vroland/epdiy-hardware/adapters/40_to_WP27D-P050VA3/40_to_WP27D-P050VA3.kicad_pcb

## KiCad design adapters/40_to_WP27D-P050VA3/40_to_WP27D-P050VA3.kicad_pcb (2025-03-17)

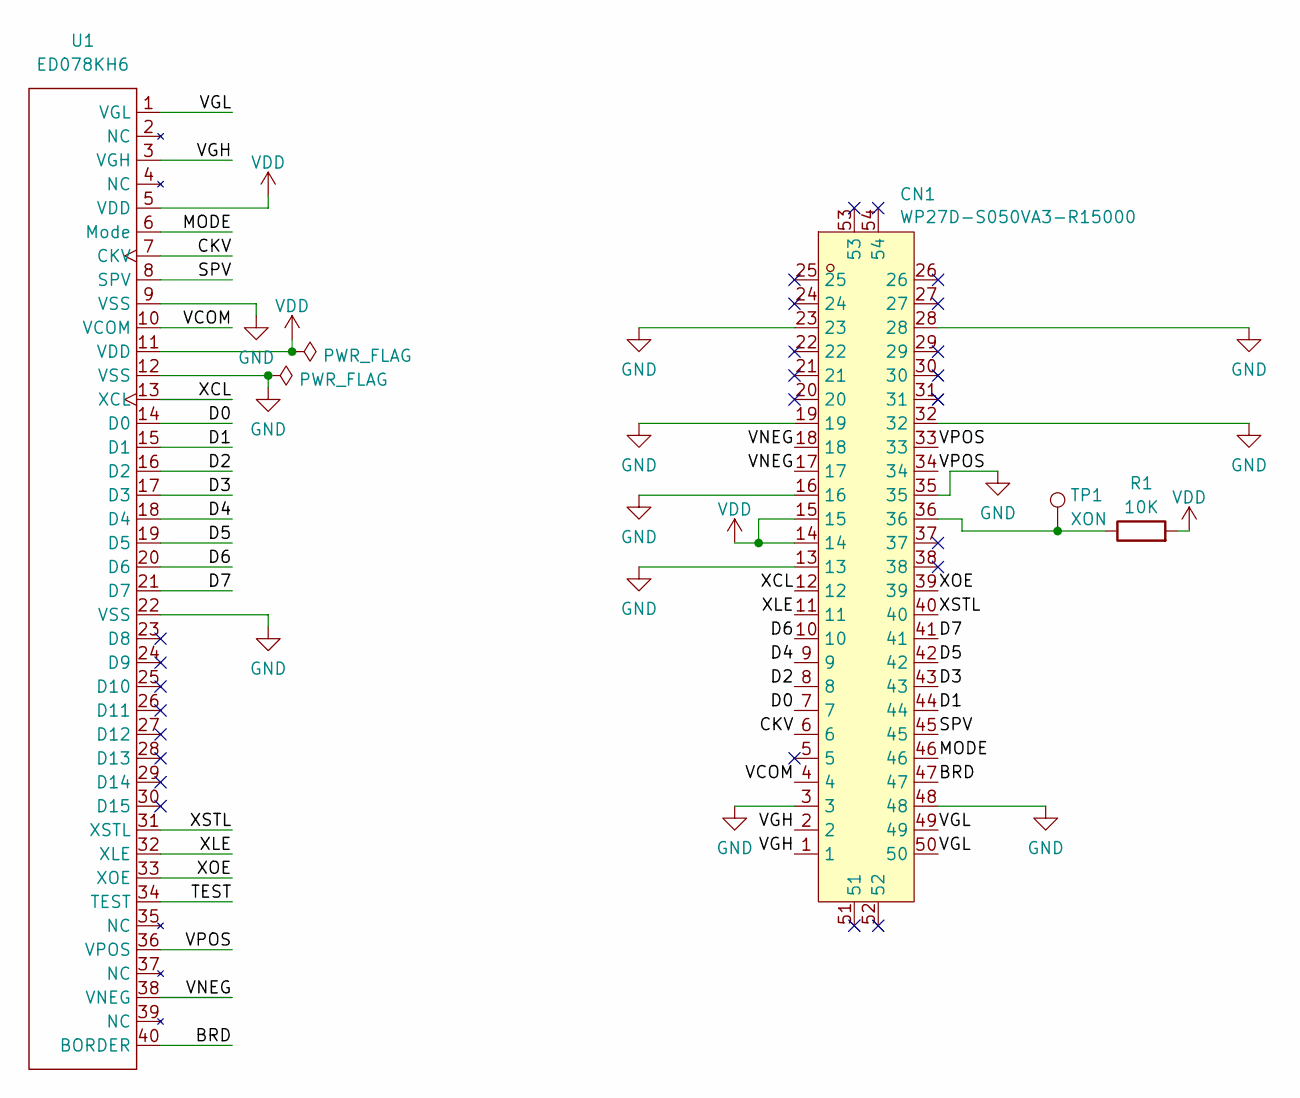
[picture p3: schematic 40_to_WP27D-P050VA3.kicad_sch]

Parts:
CN1: WP27D-S050VA3-R15000; CONN-SMD_50P-P0.35_WP27D-S050VA3; LCSC Part C3640690
R1: 10K; R_0603_1608Metric; LCSC C25804
TP1: XON; TestPoint_Pad_1.0x1.0mm
U1: ED078KH6; Hirose_FH12-40S-0.5SH_mirrored; LCSC C202114

Connections:
/BRD: CN1.47, U1.40 (BORDER)
/CKV: CN1.6, U1.7 (CKV)
/D0: CN1.7, U1.14 (D0)
/D1: CN1.44, U1.15 (D1)
/D2: CN1.8, U1.16 (D2)
/D3: CN1.43, U1.17 (D3)
/D4: CN1.9, U1.18 (D4)
/D5: CN1.42, U1.19 (D5)
/D6: CN1.10, U1.20 (D6)
/D7: CN1.41, U1.21 (D7)
/MODE: CN1.46, U1.6 (Mode)
/SPV: CN1.45, U1.8 (SPV)
/TEST: U1.34 (TEST)
/VCOM: CN1.4, U1.10 (VCOM)
/VGH: CN1.1, CN1.2, U1.3 (VGH)
/VGL: CN1.49, CN1.50, U1.1 (VGL)
/VNEG: CN1.17, CN1.18, U1.38 (VNEG)
/VPOS: CN1.33, CN1.34, U1.36 (VPOS)
/XCL: CN1.12, U1.13 (XCL)
/XLE: CN1.11, U1.32 (XLE)
/XOE: CN1.39, U1.33 (XOE)
/XSTL: CN1.40, U1.31 (XSTL)
GND: CN1.3, CN1.13, CN1.16, CN1.19, CN1.23, CN1.28, CN1.32, CN1.35, CN1.48, U1.9 (VSS), U1.12 (VSS), U1.22 (VSS)
unnamed: CN1.36, R1.1, TP1.1
VDD: CN1.14, CN1.15, R1.2, U1.5 (VDD), U1.11 (VDD)

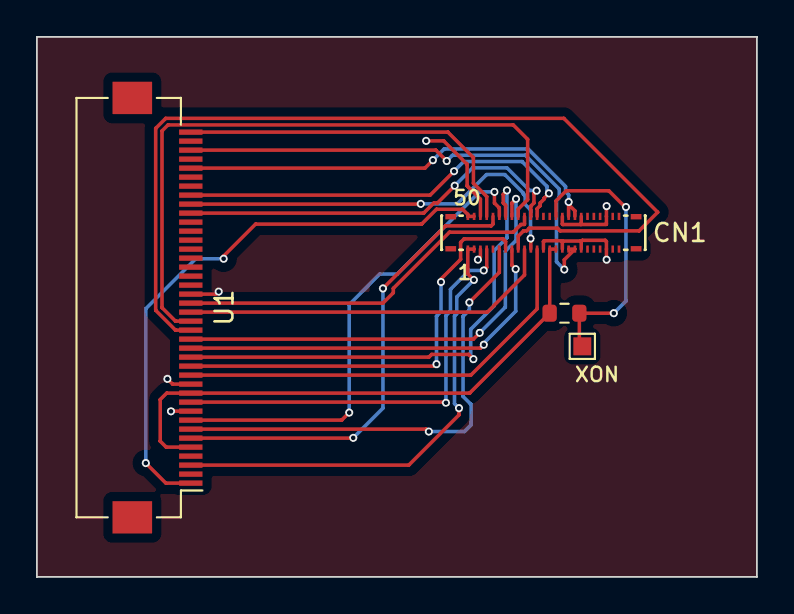
[picture p4: board 40_to_WP27D-P050VA3.kicad_pcb from above]

Board: 2 copper layers, 40.0 x 30.0 mm, 4 parts (0 on the bottom side), 24 nets.
