vroland/epdiy-hardware/epdiy-v7-raw/epdiy-v7-raw.kicad_pcb

## KiCad design epdiy-v7-raw/epdiy-v7-raw.kicad_pcb (2025-03-17)

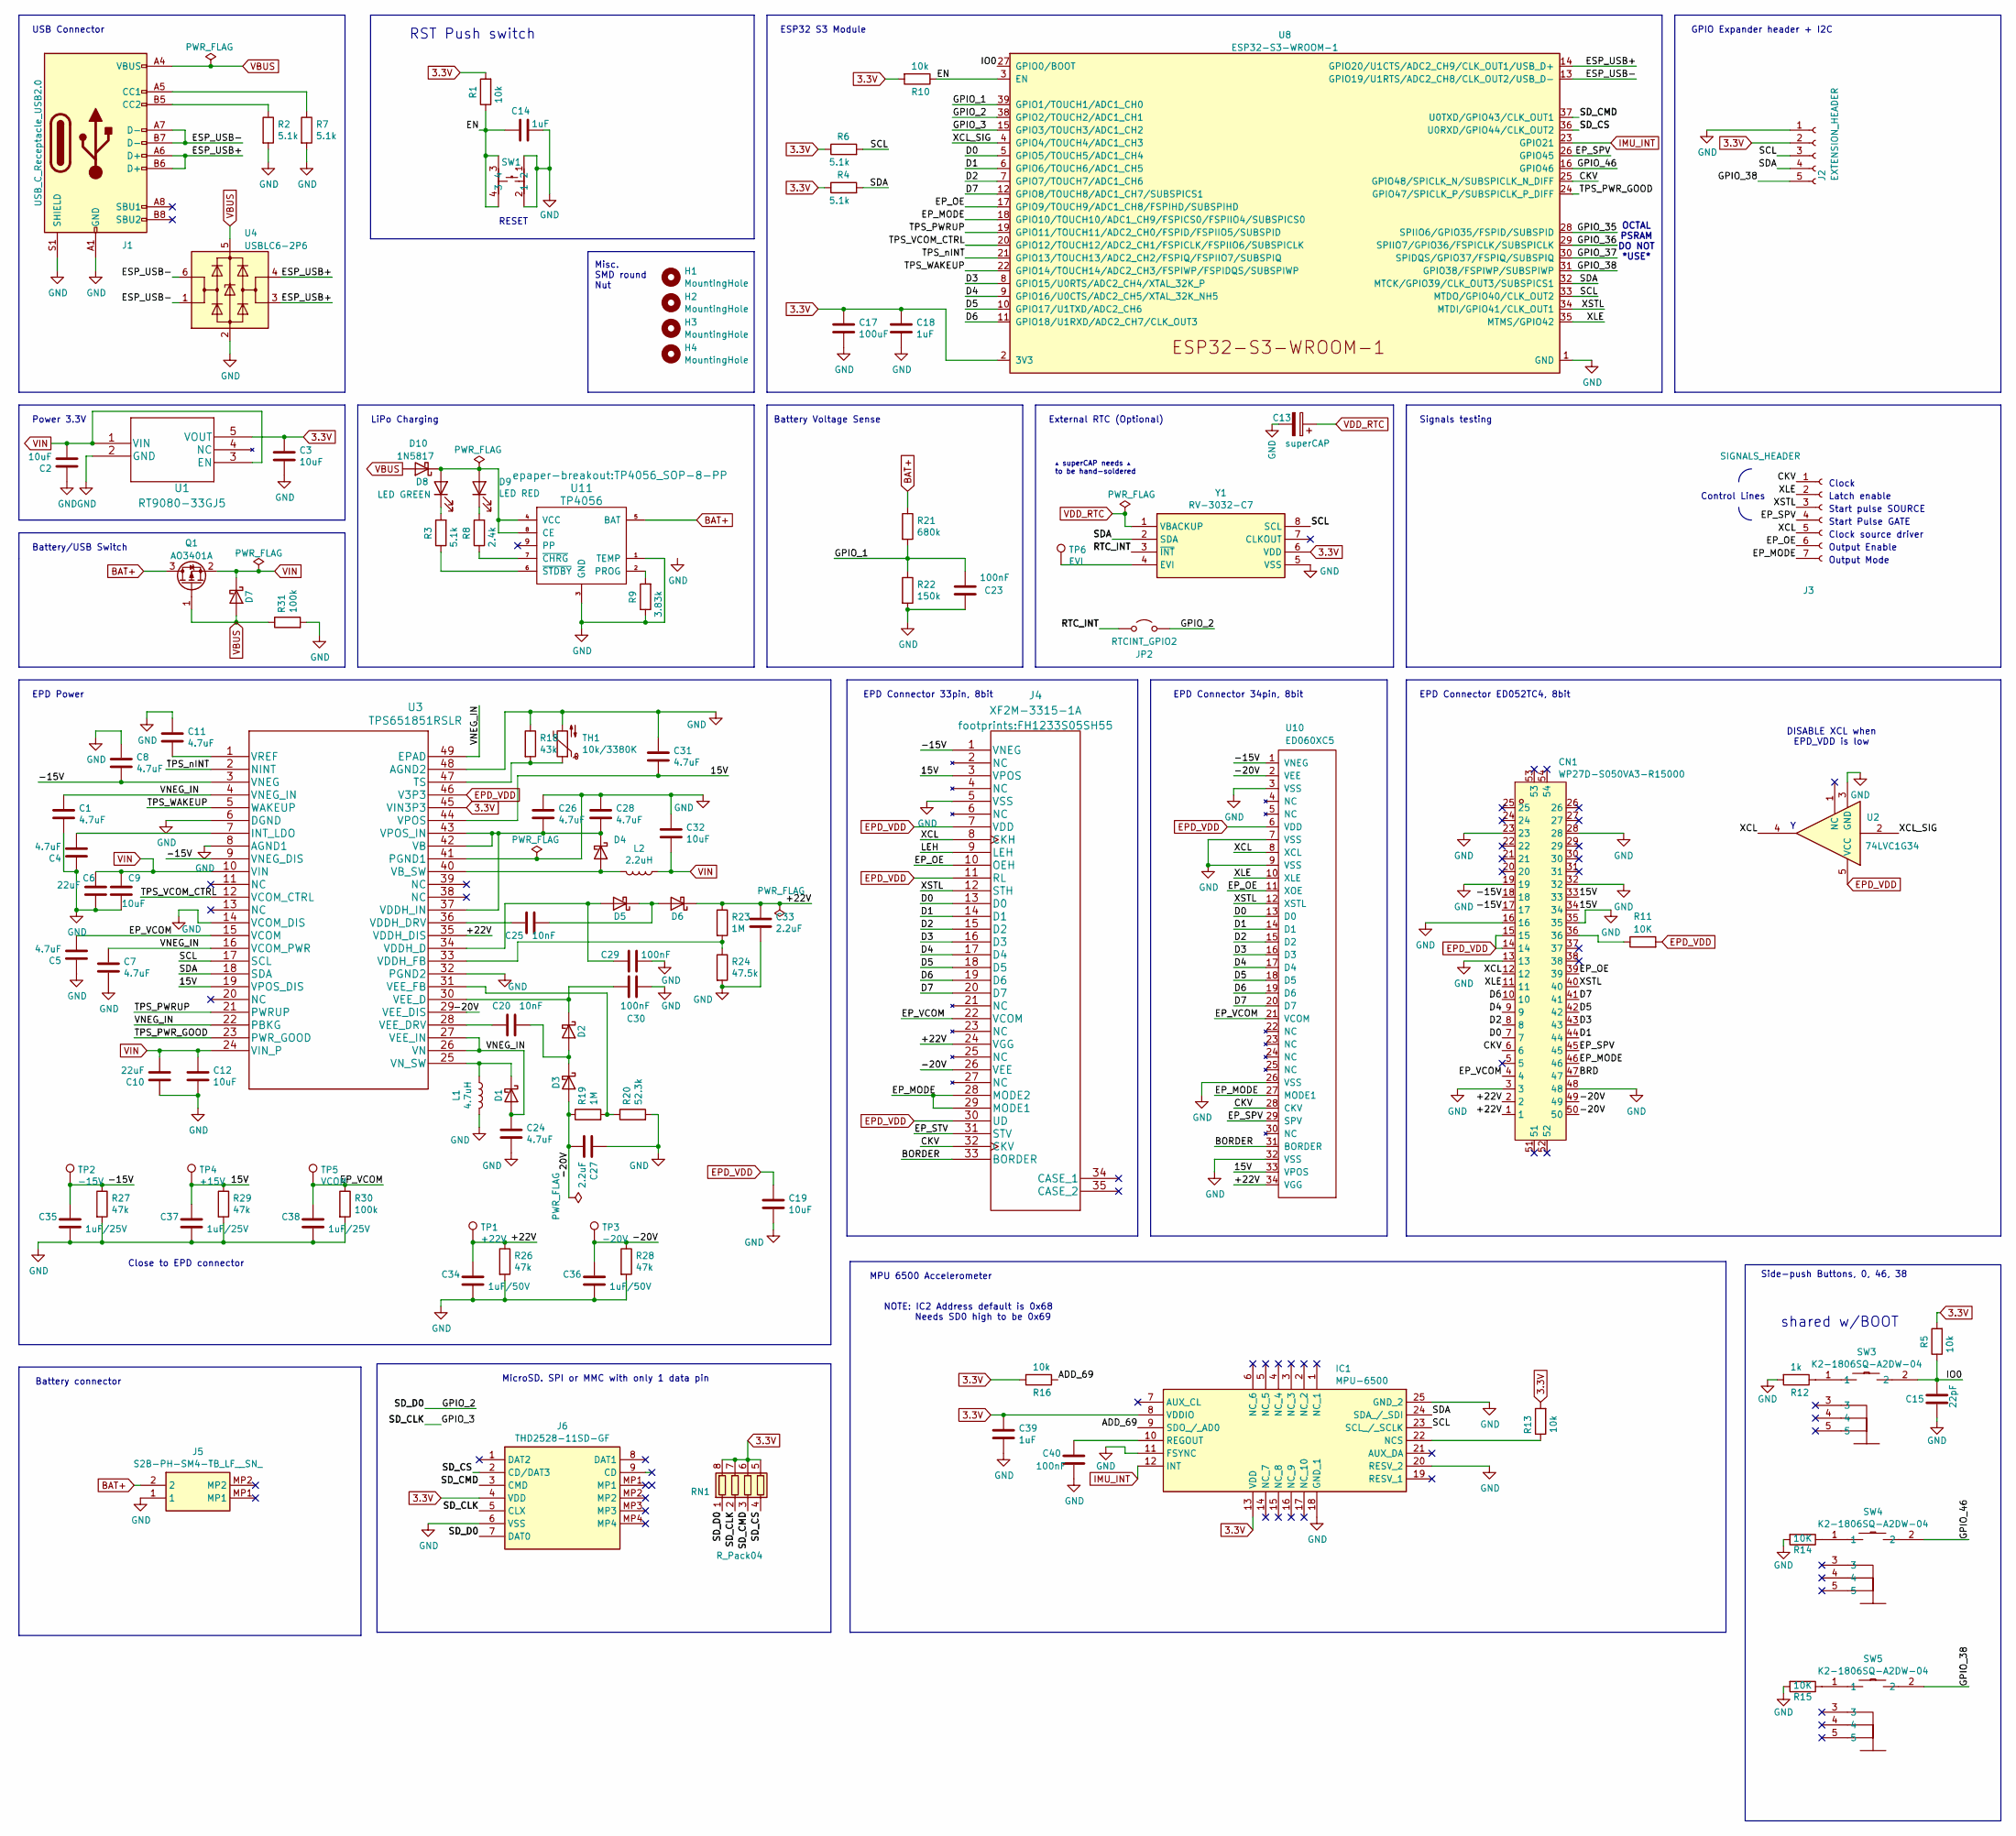
[picture p5: schematic epdiy-v7-raw.kicad_sch, epdiy]

Parts:
C1, C4, C5, C7, C8, C11, C24, C26, C28, C31: 4.7uF; C_0805_2012Metric; LCSC C1779
C2, C3, C9, C12, C19, C32: 10uF; C_0805_2012Metric; LCSC C15850
C6, C10: 22uF; C_0805_2012Metric; LCSC C45783
C13: superCAP; C9900013866_SUPERCAP-TH_XH414HG; LCSC C129289
C14: 1uF; C_0402_1005Metric; LCSC C162161
C15: 22pF; C_0402_1005Metric; LCSC C5119318
C17: 100uF; CP_EIA-3528-15_AVX-H; LCSC C16133
C18, C39: 1uF; C_0805_2012Metric; LCSC C28323
C20, C25: 10nF; C_0805_2012Metric; LCSC C1710
C23, C29, C30, C40: 100nF; C_0805_2012Metric; LCSC C49678
C27, C33: 2.2uF; C_0805_2012Metric; LCSC C49217
C34, C36: 1uF/50V; C_1206_3216Metric; LCSC C1848
C35, C37, C38: 1uF/25V; C_0805_2012Metric; LCSC C28323
CN1: WP27D-S050VA3-R15000; CONN-SMD_50P-P0.35_WP27D-S050VA3; LCSC Part C3640690
D1, D2, D3, D4, D5, D6, D7: MBR0540; D_SOD-123; LCSC C21353
D8: LED GREEN; LED_0805_2012Metric; LCSC C2297
D9: LED RED; LED_0805_2012Metric; LCSC C84256
D10: 1N5817; D_SOD-123; LCSC C8598
H1, H2, H3, H4: MountingHole; C2916320_SMTSO2015CTJ; LCSC C2916320
IC1: MPU-6500; C50278_IMU_QFN-24_L3.0-W3.0-P0.40-BL-EP; Manufacturer_Part_Number MPU-6500; Mouser Part Number 410-MPU-6500
J1: USB_C_Receptacle_USB2.0; USB_C_Receptacle_HRO_TYPE-C-31-M-12; LCSC C165948
J2: EXTENSION_HEADER; PinHeader_1x05_P2.54mm_Vertical
J3: SIGNALS_HEADER; PinHeader_1x07_P2.54mm_Vertical
J4: XF2M-3315-1A; FH1233S05SH55; LCSC C597986
J5: S2B-PH-SM4-TB_LF__SN_; S2BPHSM4TBLFSN; Manufacturer_Part_Number S2B-PH-SM4-TB(LF)(SN); LCSC C295747
J6: THD2528-11SD-GF; MicroSD_THD252811SDGF; Manufacturer_Part_Number THD2528-11SD-GF; LCSC C283232
JP2: RTCINT_GPIO2; SolderJumper-2_P1.3mm_Open_Pad1.0x1.5mm
L1: 4.7uH; L_Taiyo-Yuden_NR-50xx_HandSoldering; LCSC C222947
L2: 2.2uH; L_Taiyo-Yuden_NR-40xx_HandSoldering; LCSC C92959
Q1: AO3401A; SOT-23; LCSC C15127
R1, R5: 10k; R_0402_1005Metric; LCSC C4322213
R2, R3, R4, R6, R7: 5.1k; R_0603_1608Metric; LCSC C23186
R8: 2.4k; R_0603_1608Metric; LCSC C22940
R9: 3.83k; R_0603_1608Metric; LCSC C103591
R10, R13, R16: 10k; R_0603_1608Metric; LCSC C25804
R11, R14, R15: 10K; R_0603_1608Metric; LCSC C25804
R12: 1k; R_0402_1005Metric; LCSC C21190
R18: 43k; R_0603_1608Metric; LCSC C23172
R19, R23: 1M; R_0603_1608Metric; LCSC C22935
R20: 52.3k; R_0603_1608Metric; LCSC C23196
R21: 680k; R_0603_1608Metric; LCSC C25822
R22: 150k; R_0603_1608Metric; LCSC C22807
R24: 47.5k; R_0603_1608Metric; LCSC C25819
R26, R27, R28, R29: 47k; R_0603_1608Metric; LCSC C25819
R30, R31: 100k; R_0603_1608Metric; LCSC C25803
RN1: R_Pack04; RESN_F392JTCE_UNR_SD-pullup; LCSC C425297
SW1: TC-0522C-1.7-160G; C2845289_SW-SMD_4P-L5.2-W5.2-P3.70-LS6.4; LCSC Part C2845289
SW3, SW4, SW5: K2-1806SQ-A2DW-04; C5143621_KEY-SMD_TS24ZJ; LCSC Part C5143621
TH1: 10k/3380K; R_0603_1608Metric; LCSC C76589
TP1: +22V; TestPoint_Pad_D2.5mm
TP2: -15V; TestPoint_Pad_D2.5mm
TP3: -20V; TestPoint_Pad_D2.5mm
TP4: +15V; TestPoint_Pad_D2.5mm
TP5: VCOM; TestPoint_Pad_D2.5mm
TP6: EVI; TestPoint_Pad_D2.5mm
U1: RT9080-33GJ5; TSOT-23-5; LCSC C841192
U2: 74LVC1G34; SOT-23-5
U3: TPS651851RSLR; LCSC C139292
U4: USBLC6-2P6; SOT-666; LCSC C2827693
U8: ESP32-S3-WROOM-1; LCSC C2913202
U10: ED060XC5; X05A20H34G; LCSC C528053
U11: TP4056; TP4056_SOP-8-PP; LCSC C16581
Y1: RV-3032-C7; RV3032C7; LCSC C5127802

Connections:
3.3V: C3.2, C17.1, C18.2, C39.2, IC1.8 (VDDIO), IC1.13 (VDD), J2.2, J6.4 (VDD), R1.2, R4.1, R5.2, R6.1, R10.2, R13.2, R16.2, RN1.5 (R4.2), RN1.6 (R3.2), RN1.7 (R2.2), RN1.8 (R1.2), U1.5 (VOUT), U3.45 (VIN3P3), U8.2 (3V3), Y1.6 (VDD); also elsewhere on the board
/15V: C31.2, C37.1, CN1.33, CN1.34, J4.3 (VPOS), R29.1, TP4.1, U3.19 (VPOS_DIS), U3.44 (VPOS), U10.33 (VPOS)
/+22V: C33.1, C34.1, CN1.1, CN1.2, D6.1 (K), J4.24 (VGG), R23.1, R26.1, TP1.1, U3.35 (VDDH_DIS), U10.34 (VGG)
/-15V: C8.2, C35.1, CN1.17, CN1.18, J4.1 (VNEG), R27.1, TP2.1, U3.3 (VNEG), U3.9 (VNEG_DIS), U10.1 (VNEG)
/-20V: C27.2, C36.1, CN1.49, CN1.50, D3.2 (A), J4.26 (VEE), R19.1, R28.1, TP3.1, U3.29 (VEE_DIS), U10.2 (VEE)
/ADD_69: IC1.9 (SDO_/_AD0), R16.1
/BORDER: J4.33 (BORDER), U10.31 (BORDER)
/BRD: CN1.47
/CKV: CN1.6, J3.1, J4.32 (CKV), U8.25 (GPIO48/SPICLK_N/SUBSPICLK_N_DIFF), U10.28 (CKV)
/D0: CN1.7, J4.13 (D0), U8.5 (GPIO5/TOUCH5/ADC1_CH4), U10.13 (D0)
/D1: CN1.44, J4.14 (D1), U8.6 (GPIO6/TOUCH6/ADC1_CH5), U10.14 (D1)
/D2: CN1.8, J4.15 (D2), U8.7 (GPIO7/TOUCH7/ADC1_CH6), U10.15 (D2)
/D3: CN1.43, J4.16 (D3), U8.8 (GPIO15/U0RTS/ADC2_CH4/XTAL_32K_P), U10.16 (D3)
/D4: CN1.9, J4.17 (D4), U8.9 (GPIO16/U0CTS/ADC2_CH5/XTAL_32K_NH5), U10.17 (D4)
/D5: CN1.42, J4.18 (D5), U8.10 (GPIO17/U1TXD/ADC2_CH6), U10.18 (D5)
/D6: CN1.10, J4.19 (D6), U8.11 (GPIO18/U1RXD/ADC2_CH7/CLK_OUT3), U10.19 (D6)
/D7: CN1.41, J4.20 (D7), U8.12 (GPIO8/TOUCH8/ADC1_CH7/SUBSPICS1), U10.20 (D7)
/EN: C14.2, R1.1, R10.1, SW1.3, SW1.4, U8.3 (EN)
/EP_MODE: CN1.46, J3.7, J4.28 (MODE2), J4.29 (MODE1), U8.18 (GPIO10/TOUCH10/ADC1_CH9/FSPICS0/FSPIIO4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), U10.27 (MODE1)
/EP_OE: CN1.39, J3.6, J4.10 (OEH), U8.17 (GPIO9/TOUCH9/ADC1_CH8/FSPIHD/SUBSPIHD), U10.11 (XOE)
/EP_SPV: CN1.45, J3.4, U8.26 (GPIO45), U10.29 (SPV)
/EP_VCOM: C5.2, C38.1, CN1.4, J4.22 (VCOM), R30.1, TP5.1, U3.15 (VCOM), U10.21 (VCOM)
/ESP_USB+: J1.A6 (D+), J1.B6 (D+), U4.3 (I/O2), U4.4 (I/O2), U8.14 (GPIO20/U1CTS/ADC2_CH9/CLK_OUT1/USB_D+)
/ESP_USB-: J1.A7 (D-), J1.B7 (D-), U4.1 (I/O1), U4.6 (I/O1), U8.13 (GPIO19/U1RTS/ADC2_CH8/CLK_OUT2/USB_D-)
/GPIO_1: C23.2, R21.2, R22.1, U8.39 (GPIO1/TOUCH1/ADC1_CH0)
/GPIO_2: J6.7 (DAT0), JP2.2 (B), RN1.1 (R1.1), U8.38 (GPIO2/TOUCH2/ADC1_CH1)
/GPIO_3: J6.5 (CLX), RN1.2 (R2.1), U8.15 (GPIO3/TOUCH3/ADC1_CH2)
/GPIO_35: U8.28 (SPIIO6/GPIO35/FSPID/SUBSPID)
/GPIO_36: U8.29 (SPIIO7/GPIO36/FSPICLK/SUBSPICLK)
/GPIO_37: U8.30 (SPIDQS/GPIO37/FSPIQ/SUBSPIQ)
/GPIO_38: J2.5, SW5.2, U8.31 (GPIO38/FSPIWP/SUBSPIWP)
/GPIO_46: SW4.2, U8.16 (GPIO46)
/IO0: C15.2, R5.1, SW3.2, U8.27 (GPIO0/BOOT)
/RTC_INT: JP2.1 (A), Y1.3 (~INT); also elsewhere on the board
/SCL: IC1.23 (SCL_/_SCLK), J2.3, R6.2, U3.17 (SCL), U8.33 (MTDO/GPIO40/CLK_OUT2), Y1.8 (SCL)
/SDA: IC1.24 (SDA_/_SDI), J2.4, R4.2, U3.18 (SDA), U8.32 (MTCK/GPIO39/CLK_OUT3/SUBSPICS1), Y1.2 (SDA)
/SD_CMD: J6.3 (CMD), RN1.3 (R3.1), U8.37 (U0TXD/GPIO43/CLK_OUT1)
/SD_CS: J6.2 (CD/DAT3), RN1.4 (R4.1), U8.36 (U0RXD/GPIO44/CLK_OUT2)
/TPS_PWRUP: U3.21 (PWRUP), U8.19 (GPIO11/TOUCH11/ADC2_CH0/FSPID/FSPIIO5/S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)
/TPS_PWR_GOOD: U3.23 (PWR_GOOD), U8.24 (GPIO47/SPICLK_P/SUBSPICLK_P_DIFF)
/TPS_VCOM_CTRL: U3.12 (VCOM_CTRL), U8.20 (GPIO12/TOUCH12/ADC2_CH1/FSPICLK/FSPIIO6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)
/TPS_WAKEUP: U3.5 (WAKEUP), U8.22 (GPIO14/TOUCH14/ADC2_CH3/FSPIWP/FSPIDQS/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)
/TPS_nINT: U3.2 (NINT), U8.21 (GPIO13/TOUCH13/ADC2_CH2/FSPIQ/FSPIIO7/S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)
/VNEG_IN: C1.1, C7.1, C24.1, D1.2 (A), U3.4 (VNEG_IN), U3.16 (VCOM_PWR), U3.22 (PBKG), U3.26 (VN), U3.27 (VEE_IN), U3.49 (EPAD)
/XCL: CN1.12, J3.5, J4.8 (CKH), U2.4, U10.8 (XCL)
/XCL_SIG: U2.2, U8.4 (GPIO4/TOUCH4/ADC1_CH3)
/XLE: CN1.11, J3.2, U8.35 (MTMS/GPIO42), U10.10 (XLE)
/XSTL: CN1.40, J3.3, J4.12 (STH), U8.34 (MTDI/GPIO41/CLK_OUT1), U10.12 (XSTL)
BAT+: J5.2, Q1.3 (D), R21.1, U11.5 (BAT); also elsewhere on the board
EPD_VDD: C19.1, CN1.14, CN1.15, J4.7 (VDD), J4.11 (RL), J4.30 (UD), R11.2, U2.5 (VCC), U3.46 (V3P3), U10.6 (VDD)
IMU_INT: IC1.12 (INT), U8.23 (GPIO21)
unnamed: CN1.36, R11.1
unnamed: D1.1 (K), L1.1, U3.25 (VN_SW)
unnamed: C20.1, D2.2 (A), D3.1 (K)
unnamed: C30.1, D2.1 (K), U3.30 (VEE_D)
unnamed: D4.2 (A), L2.2, U3.40 (VB_SW)
unnamed: C26.2, C28.2, D4.1 (K), U3.37 (VDDH_IN), U3.42 (VB), U3.43 (VPOS_IN)
unnamed: C29.2, D5.2 (A), U3.34 (VDDH_D)
unnamed: C25.1, D5.1 (K), D6.2 (A)
unnamed: D8.1 (K), R3.2
unnamed: D9.1 (K), R8.2
unnamed: D8.2 (A), D9.2 (A), D10.1 (K), U11.4 (VCC), U11.8 (CE)
unnamed: IC1.22 (NCS), R13.1
unnamed: C40.1, IC1.10 (REGOUT)
unnamed: J1.A5 (CC1), R7.1
unnamed: J1.B5 (CC2), R2.1
unnamed: R12.1, SW3.1
unnamed: R14.1, SW4.1
unnamed: R15.1, SW5.1
unnamed: C4.2, U3.7 (INT_LDO)
unnamed: R18.2, TH1.1, U3.47 (TS)
unnamed: C25.2, U3.36 (VDDH_DRV)
unnamed: R23.2, R24.1, U3.33 (VDDH_FB)
unnamed: C20.2, U3.28 (VEE_DRV)
unnamed: R19.2, R20.1, U3.31 (VEE_FB)
unnamed: C11.2, U3.1 (VREF)
unnamed: R9.2, U11.2 (PROG)
unnamed: R8.1, U11.7 (~CHRG)
unnamed: R3.1, U11.6 (~STDBY)
unnamed: TP6.1, Y1.4 (EVI)
VDD_RTC: C13.1, Y1.1 (VBACKUP)
VIN: C2.1, C6.2, C9.1, C10.2, C12.1, C32.2, D7.1 (K), L2.1, Q1.2 (S), U1.1 (VIN), U1.3 (EN), U3.10 (VIN), U3.24 (VIN_P)

Notes on the sheet:
NOTE: IC2 Address default is 0x68 Needs SD0 high to be 0x69
Start pulse SOURCE
Battery Voltage Sense
Misc. SMD round Nut
EPD Power
Signals testing
GPIO Expander header + I2C
USB Connector
shared w/BOOT
MPU 6500 Accelerometer
ESP32 S3 Module
Clock
Side-push Buttons, 0, 46, 38
EPD Connector ED052TC4, 8bit
Power 3.3V
Clock source driver
▴ superCAP needs ▴ to be hand-soldered
EPD Connector 33pin, 8bit
OCTAL PSRAM DO NOT *USE*
Output Enable
RESET
Battery/USB Switch
RST Push switch
External RTC (Optional)
Latch enable
Start Pulse GATE
EPD Connector 34pin, 8bit
DISABLE XCL when EPD_VDD is low
Output Mode
Battery connector
MicroSD. SPI or MMC with only 1 data pin
LiPo Charging
Close to EPD connector
Control Lines

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
