vroland/epdiy-hardware/epdiy-v7-raw/epdiy-v7-raw.kicad_pcb

## KiCad design epdiy-v7-raw/epdiy-v7-raw.kicad_pcb (continued)

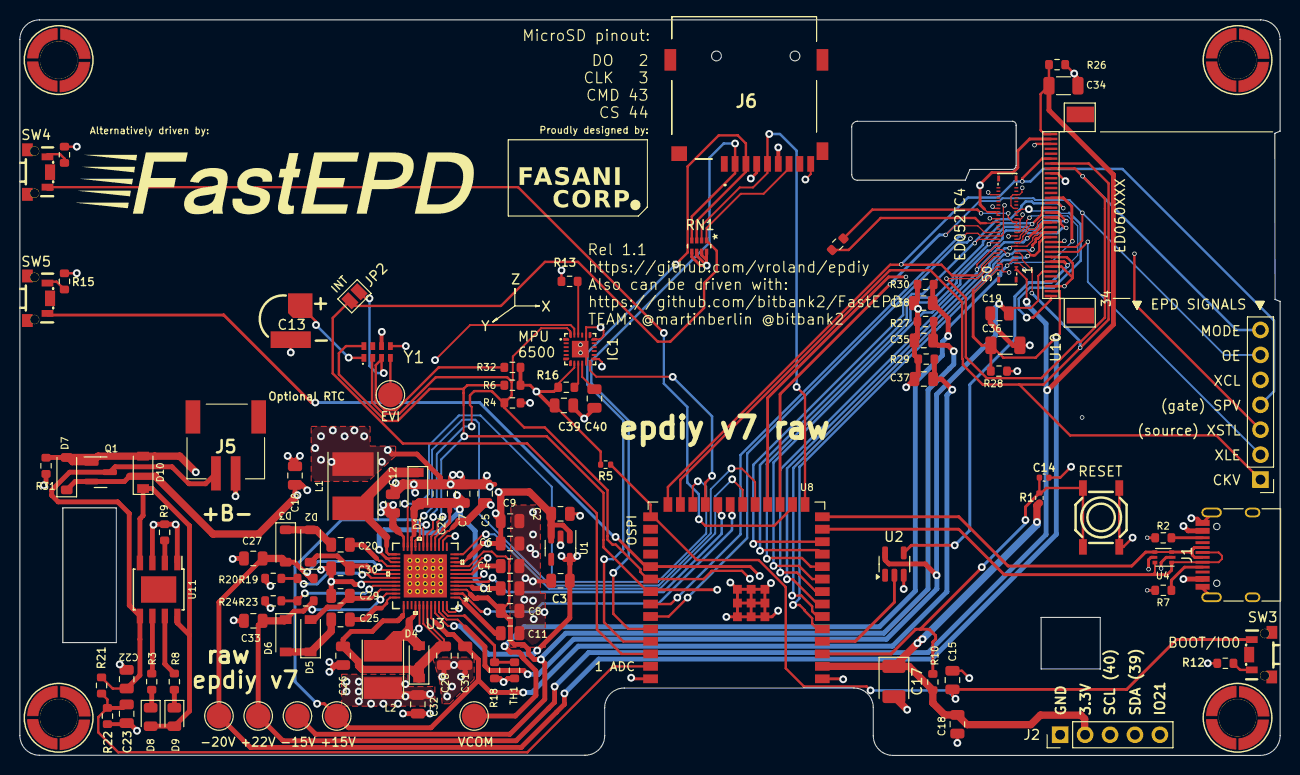
[picture p6: board epdiy-v7-raw.kicad_pcb from above]

Board: 4 copper layers, 128.4 x 74.9 mm, 113 parts (0 on the bottom side), 79 nets.

Other parts of the board:
C22: 100nF; C_0805_2012Metric
R32: 10k; R_0603_1608Metric

Their connections:
3.3V: R32.2; also elsewhere on the board
/RTC_INT: R32.1; also elsewhere on the board
BAT+: C22.2; also elsewhere on the board
