vroland/epdiy-hardware/epdiy-v5/epdiy-v5.kicad_pcb

## KiCad design epdiy-v5/epdiy-v5.kicad_pcb (2024-04-22, an earlier design)

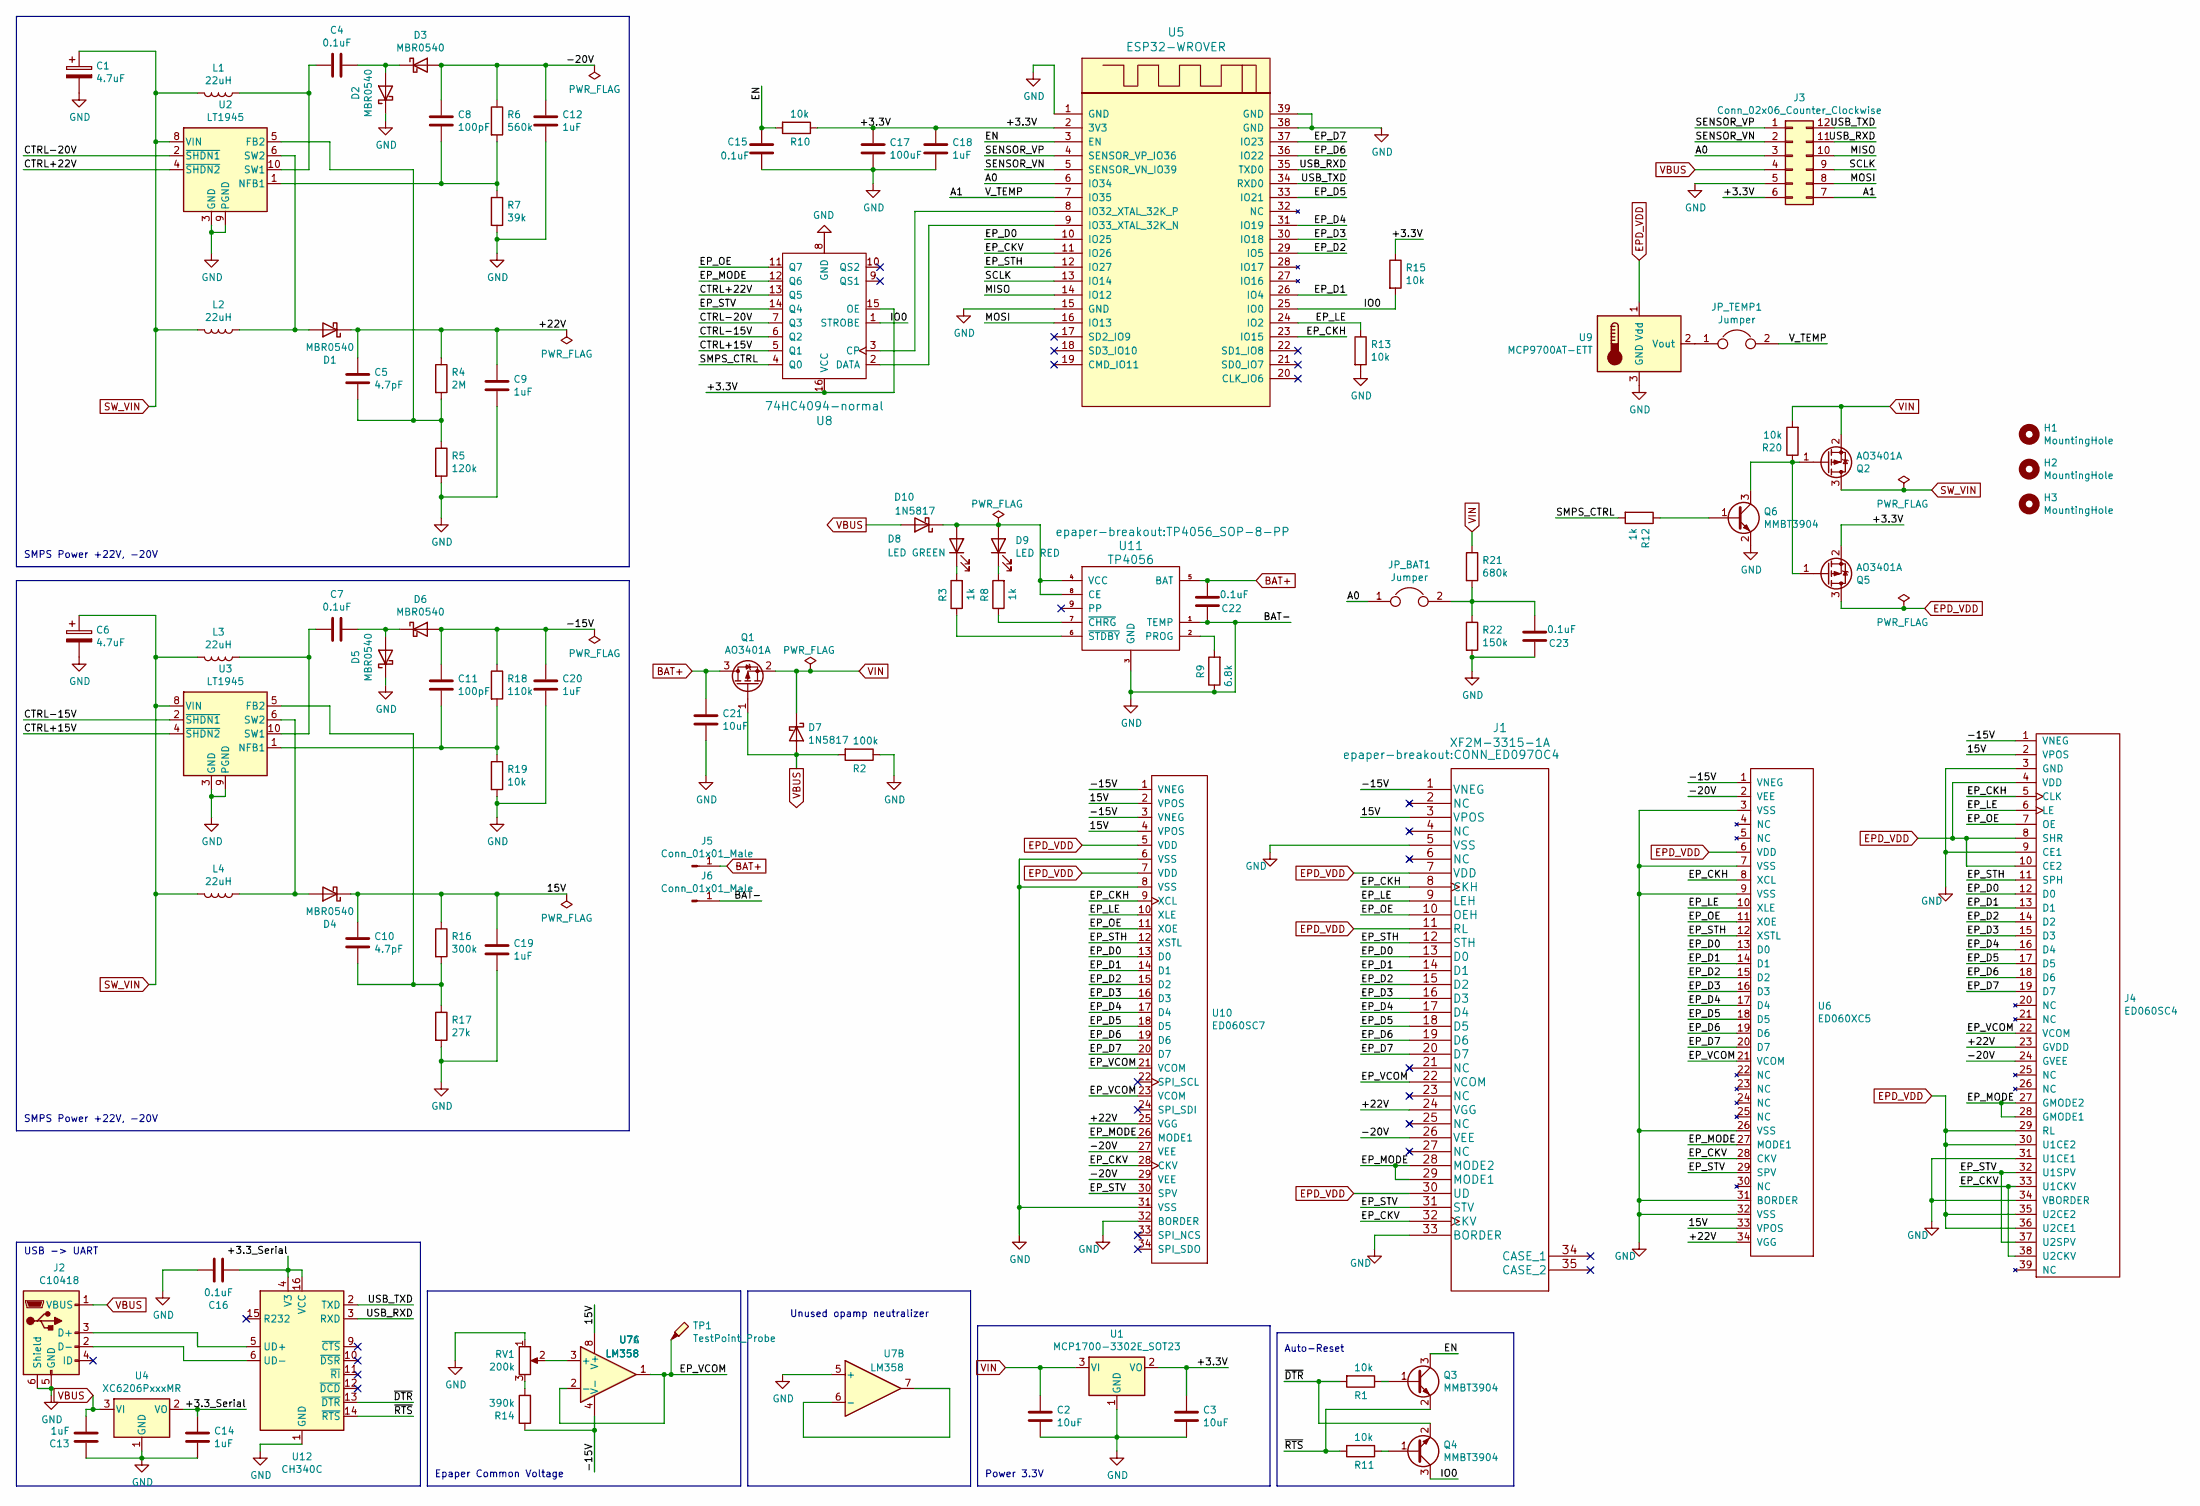
[picture p9: schematic epdiy-v5.kicad_sch, epdiy]

Parts:
C1, C6: 4.7uF; C_0603_1608Metric; LCSC C19666
C2, C3, C21: 10uF; C_0603_1608Metric; LCSC C19702
C4, C7, C16, C22, C23: 0.1uF; C_0603_1608Metric; LCSC C14663
C5, C10: 4.7pF; C_0603_1608Metric; LCSC C1669
C8, C11: 100pF; C_0603_1608Metric; LCSC C14858
C9, C12, C13, C14, C18, C19, C20: 1uF; C_0603_1608Metric; LCSC C15849
C15: 0.1uF; C_0603_1608Metric; LCSC C1588
C17: 100uF; CP_EIA-3528-15_AVX-H; LCSC C16133
D1, D2, D3, D4, D5, D6: MBR0540; D_SOD-123; LCSC C21353
D7, D10: 1N5817; D_SOD-123; LCSC C8598
D8: LED GREEN; LED_0805_2012Metric; LCSC C2297
D9: LED RED; LED_0805_2012Metric; LCSC C84256
H1, H2, H3: MountingHole; MountingHole_2.2mm_M2
J1: XF2M-3315-1A; CONN_ED097OC4; LCSC C231420
J2: C10418; USB_Micro-B_A01SB141B1-067; LCSC C10418
J3: Conn_02x06_Counter_Clockwise; PinHeader_2x06_P2.54mm_Vertical
J4: ED060SC4; HRS_FH26W-39S-0.3SHW(60); LCSC C92280
J5, J6: Conn_01x01_Male; PinHeader_1x01_P2.54mm_Vertical
JP_BAT1: Jumper; SolderJumper-2_P1.3mm_Bridged2Bar_RoundedPad1.0x1.5mm
JP_TEMP1: Jumper; SolderJumper-2_P1.3mm_Bridged2Bar_RoundedPad1.0x1.5mm
L1, L2, L3, L4: 22uH; L_6.3x6.3_H3; LCSC C206321
Q1, Q2, Q5: AO3401A; SOT-23; LCSC C15127
Q3, Q4, Q6: MMBT3904; SOT-23; LCSC C20526
R1, R10, R11, R13, R15, R19, R20: 10k; R_0805_2012Metric; LCSC C17414
R2: 100k; R_0805_2012Metric; LCSC C17407
R3, R8, R12: 1k; R_0805_2012Metric; LCSC C17513
R4: 2M; R_0805_2012Metric; LCSC C26112
R5: 120k; R_0805_2012Metric; LCSC C17436
R6: 560k; R_0805_2012Metric; LCSC C15785
R7: 39k; R_0805_2012Metric; LCSC C25826
R9: 6.8k; R_0805_2012Metric; LCSC C17772
R14: 390k; R_0805_2012Metric; LCSC C17656
R16: 300k; R_0805_2012Metric; LCSC C17616
R17: 27k; R_0805_2012Metric; LCSC C17593
R18: 110k; R_0805_2012Metric; LCSC C17422
R21: 680k; R_0805_2012Metric; LCSC C17797
R22: 150k; R_0805_2012Metric; LCSC C17470
RV1: 200k; EVM3ESX50B25; LCSC C11958
TP1: TestPoint_Probe; TestPoint_Pad_D1.0mm
U1: MCP1700-3302E_SOT23; SOT-23; LCSC C39051
U2, U3: LT1945; MSOP-10_3x3mm_P0.5mm
U4: XC6206PxxxMR; SOT-23; LCSC C5446
U5: ESP32-WROVER; LCSC C503591
U6: ED060XC5; X05A20H34G
U7: LM358; SOP-8_3.76x4.96mm_P1.27mm
U8: 74HC4094-normal; SOIC-16_3.9x9.9mm_P1.27mm; LCSC C5651
U9: MCP9700AT-ETT; SOT-23; LCSC C127949
U10: ED060SC7; AXT334124
U11: TP4056; TP4056_SOP-8-PP; LCSC C16581
U12: CH340C; SOIC-16_3.9x9.9mm_P1.27mm; LCSC C84681

Connections:
/15V: C10.2, C19.2, D4.1 (K), J1.3 (VPOS), J4.2 (VPOS), R16.1, U6.33 (VPOS), U7.8 (V+), U10.2 (VPOS), U10.4 (VPOS)
/+3.3V: C3.2, C17.1, C18.2, J3.6, Q5.2 (S), R10.1, R15.1, U1.2 (VO), U5.2 (3V3), U8.15 (OE), U8.16 (VCC)
/+3.3_Serial: C14.2, C16.1, U4.2 (VO), U12.4 (V3), U12.16 (VCC)
/+22V: C5.2, C9.2, D1.1 (K), J1.24 (VGG), J4.23 (GVDD), R4.1, U6.34 (VGG), U10.25 (VGG)
/-15V: C11.2, C20.2, D6.2 (A), J1.1 (VNEG), J4.1 (VNEG), R14.1, R18.1, U6.1 (VNEG), U7.4 (V-), U10.1 (VNEG), U10.3 (VNEG)
/-20V: C8.2, C12.2, D3.2 (A), J1.26 (VEE), J4.24 (GVEE), R6.1, U6.2 (VEE), U10.27 (VEE), U10.29 (VEE)
/A0: J3.3, JP_BAT1.1, U5.6 (IO34)
/A1: J3.7, JP_TEMP1.2, U5.7 (IO35)
/CTRL+15V: U3.4 (~SHDN2), U8.5 (Q1)
/CTRL+22V: U2.4 (~SHDN2), U8.13 (Q5)
/CTRL-15V: U3.2 (~SHDN1), U8.6 (Q2)
/CTRL-20V: U2.2 (~SHDN1), U8.7 (Q3)
/EN: C15.1, Q3.3 (C), R10.2, U5.3 (EN)
/EP_CKH: J1.8 (CKH), J4.5 (CLK), U5.23 (IO15), U6.8 (XCL), U10.9 (XCL)
/EP_CKV: J1.32 (CKV), J4.33 (U1CKV), J4.38 (U2CKV), U5.11 (IO26), U6.28 (CKV), U10.28 (CKV)
/EP_D0: J1.13 (D0), J4.12 (D0), U5.10 (IO25), U6.13 (D0), U10.13 (D0)
/EP_D1: J1.14 (D1), J4.13 (D1), U5.26 (IO4), U6.14 (D1), U10.14 (D1)
/EP_D2: J1.15 (D2), J4.14 (D2), U5.29 (IO5), U6.15 (D2), U10.15 (D2)
/EP_D3: J1.16 (D3), J4.15 (D3), U5.30 (IO18), U6.16 (D3), U10.16 (D3)
/EP_D4: J1.17 (D4), J4.16 (D4), U5.31 (IO19), U6.17 (D4), U10.17 (D4)
/EP_D5: J1.18 (D5), J4.17 (D5), U5.33 (IO21), U6.18 (D5), U10.18 (D5)
/EP_D6: J1.19 (D6), J4.18 (D6), U5.36 (IO22), U6.19 (D6), U10.19 (D6)
/EP_D7: J1.20 (D7), J4.19 (D7), U5.37 (IO23), U6.20 (D7), U10.20 (D7)
/EP_LE: J1.9 (LEH), J4.6 (LE), R13.1, U5.24 (IO2), U6.10 (XLE), U10.10 (XLE)
/EP_MODE: J1.28 (MODE2), J1.29 (MODE1), J4.27 (GMODE2), J4.28 (GMODE1), U6.27 (MODE1), U8.12 (Q6), U10.26 (MODE1)
/EP_OE: J1.10 (OEH), J4.7 (OE), U6.11 (XOE), U8.11 (Q7), U10.11 (XOE)
/EP_STH: J1.12 (STH), J4.11 (SPH), U5.12 (IO27), U6.12 (XSTL), U10.12 (XSTL)
/EP_STV: J1.31 (STV), J4.32 (U1SPV), J4.37 (U2SPV), U6.29 (SPV), U8.14 (Q4), U10.30 (SPV)
/EP_VCOM: J1.22 (VCOM), J4.22 (VCOM), TP1.1, U6.21 (VCOM), U7.1, U7.2 (-), U10.21 (VCOM), U10.23 (VCOM)
/IO0: Q4.3 (C), R15.2, U5.25 (IO0), U8.1 (STROBE)
/MISO: J3.10, U5.14 (IO12)
/MOSI: J3.8, U5.16 (IO13)
/SCLK: J3.9, U5.13 (IO14)
/SENSOR_VN: J3.2, U5.5 (SENSOR_VN_IO39)
/SENSOR_VP: J3.1, U5.4 (SENSOR_VP_IO36)
/SMPS_CTRL: R12.2, U8.4 (Q0)
/USB_RXD: J3.11, U5.35 (TXD0), U12.3 (RXD)
/USB_TXD: J3.12, U5.34 (RXD0), U12.2 (TXD)
/~DTR: Q4.2 (E), R1.2, U12.13 (~DTR)
/~RTS: Q3.2 (E), R11.2, U12.14 (~RTS)
BAT+: C21.1, C22.2, J5.1, Q1.3 (D), U11.5 (BAT)
EPD_VDD: J1.7 (VDD), J1.11 (RL), J1.30 (UD), J4.4 (VDD), J4.8 (SHR), J4.10 (CE2), J4.29 (RL), J4.30 (U1CE2), J4.35 (U2CE2), J4.36 (U2CE1), Q5.3 (D), U6.6 (VDD), U9.1 (Vdd), U10.5 (VDD), U10.7 (VDD)
GND: C1.2, C2.1, C3.1, C6.2, C9.1, C12.1, C13.2, C14.1, C15.2, C16.2, C17.2, C18.1, C19.1, C20.1, C21.2, C22.1, C23.1, D2.1 (K), D5.1 (K), J1.5 (VSS), J1.33 (BORDER), J2.5 (GND), J2.6 (Shield), J3.5, J4.3 (GND), J4.9 (CE1), J4.31 (U1CE1), J4.34 (VBORDER), J6.1, Q6.2 (E), R2.1, R5.2, R7.2, R9.1, R13.2, R17.2, R19.2, R22.2, RV1.1, U1.1 (GND), U2.3 (GND), U2.7 (PGND), U2.9 (PGND), U3.3 (GND), U3.7 (PGND), U3.9 (PGND), U4.1 (GND), U5.1 (GND), U5.15 (GND), U5.38 (GND), U5.39 (GND), U6.3 (VSS), U6.7 (VSS), U6.9 (VSS), U6.26 (VSS), U6.31 (BORDER), U6.32 (VSS), U7.5 (+), U8.8 (GND), U9.3 (GND), U10.6 (VSS), U10.8 (VSS), U10.31 (VSS), U10.32 (BORDER), U11.1 (TEMP), U11.3 (GND), U12.1 (GND)
unnamed: C23.2, JP_BAT1.2, R21.2, R22.1
unnamed: D1.2 (A), L2.1, U2.6 (SW2)
unnamed: C4.1, D2.2 (A), D3.1 (K)
unnamed: D4.2 (A), L4.1, U3.6 (SW2)
unnamed: C7.1, D5.2 (A), D6.1 (K)
unnamed: D8.1 (K), R3.2
unnamed: D9.1 (K), R8.2
unnamed: D8.2 (A), D9.2 (A), D10.1 (K), U11.4 (VCC), U11.8 (CE)
unnamed: J2.3 (D+), U12.5 (UD+)
unnamed: J2.2 (D-), U12.6 (UD-)
unnamed: Q2.1 (G), Q5.1 (G), Q6.3 (C), R20.1
unnamed: Q3.1 (B), R1.1
unnamed: Q4.1 (B), R11.1
unnamed: Q6.1 (B), R12.1
unnamed: R14.2, RV1.3
unnamed: C5.1, R4.2, R5.1, U2.5 (FB2)
unnamed: C8.1, R6.2, R7.1, U2.1 (NFB1)
unnamed: C4.2, L1.1, U2.10 (SW1)
unnamed: C10.1, R16.2, R17.1, U3.5 (FB2)
unnamed: C11.1, R18.2, R19.1, U3.1 (NFB1)
unnamed: C7.2, L3.1, U3.10 (SW1)
unnamed: U5.8 (IO32_XTAL_32K_P), U8.3 (CP)
unnamed: U5.9 (IO33_XTAL_32K_N), U8.2 (DATA)
unnamed: RV1.2, U7.3 (+)
unnamed: U7.6 (-), U7.7
unnamed: JP_TEMP1.1, U9.2 (Vout)
unnamed: R9.2, U11.2 (PROG)
unnamed: R8.1, U11.7 (~CHRG)
unnamed: R3.1, U11.6 (~STDBY)
SW_VIN: C1.1, C6.1, L1.2, L2.2, L3.2, L4.2, Q2.3 (D), U2.8 (VIN), U3.8 (VIN)
VBUS: C13.1, D7.2 (A), D10.2 (A), J2.1 (VBUS), J3.4, Q1.1 (G), R2.2, U4.3 (VI)
VIN: C2.2, D7.1 (K), Q1.2 (S), Q2.2 (S), R20.2, R21.1, U1.3 (VI)

Notes on the sheet:
Epaper Common Voltage
SMPS Power +22V, -20V
USB -> UART
Unused opamp neutralizer
Power 3.3V
Auto-Reset

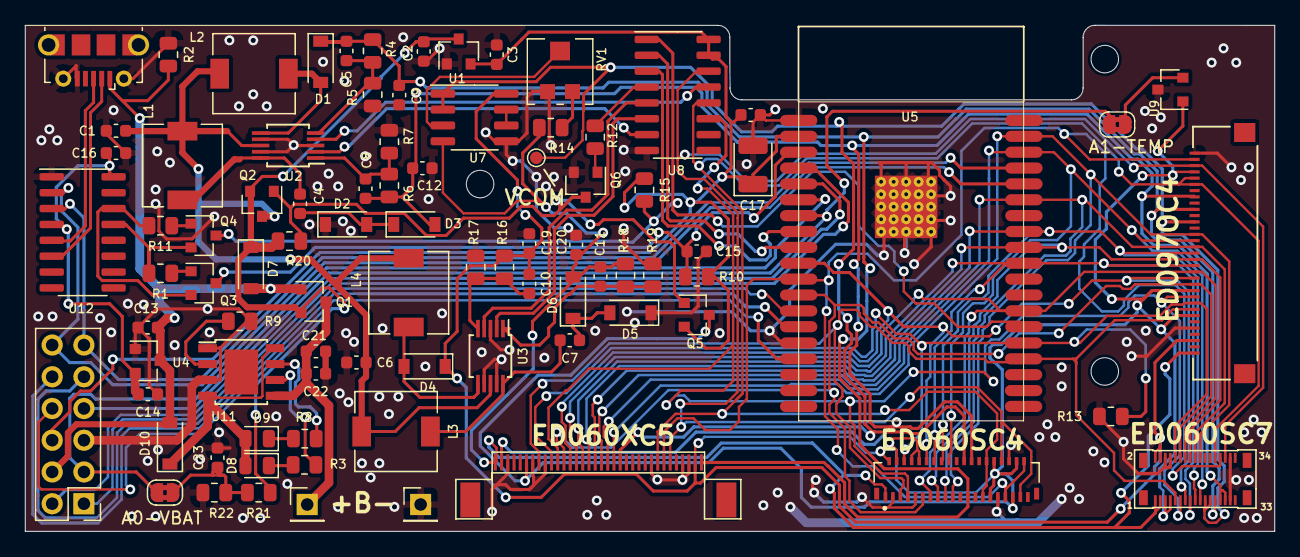
[picture p10: board epdiy-v5.kicad_pcb from above]

Board: 2 copper layers, 100.0 x 40.5 mm, 90 parts (0 on the bottom side), 75 nets.
