vroland/epdiy-hardware/adapters/9.7_40_to_34_6inch/9.7_40_to_34_6inch.kicad_pcb

## KiCad design adapters/9.7_40_to_34_6inch/9.7_40_to_34_6inch.kicad_pcb (2023-12-06)

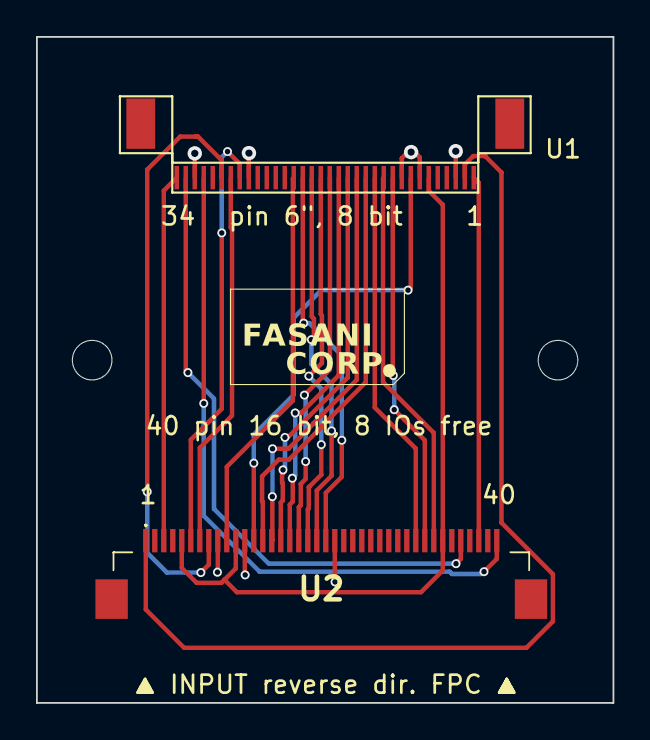
[picture p11: board 9.7_40_to_34_6inch.kicad_pcb from above]

Board: 2 copper layers, 32.0 x 37.0 mm, 4 parts (0 on the bottom side), 23 nets.

Parts:
H1, H2: MountingHole; MountingHole_2.2mm_M2
U1: ED060XC5; X05A20H34G
U2: ED078KH6; FH1240S05SH55

Connections:
/15V: U1.33 (VPOS), U2.36 (VPOS)
/+22V: U1.34 (VGG), U2.3 (VGH)
/-15V: U1.1 (VNEG), U2.38 (VNEG)
/-20V: U1.2 (VEE), U2.1 (VGL)
/BORDER: U1.31 (BORDER), U2.40 (BORDER)
/CKV: U1.28 (CKV), U2.7 (CKV)
/D0: U1.13 (D0), U2.14 (D0)
/D1: U1.14 (D1), U2.15 (D1)
/D2: U1.15 (D2), U2.16 (D2)
/D3: U1.16 (D3), U2.17 (D3)
/D4: U1.17 (D4), U2.18 (D4)
/D5: U1.18 (D5), U2.19 (D5)
/D6: U1.19 (D6), U2.20 (D6)
/D7: U1.20 (D7), U2.21 (D7)
/EP_MODE: U1.27 (MODE1), U2.6 (Mode)
/EP_OE: U1.11 (XOE), U2.33 (XOE)
/EP_STV: U1.29 (SPV), U2.8 (SPV)
/EP_VCOM: U1.21 (VCOM), U2.10 (VCOM)
/LEH: U1.10 (XLE), U2.32 (XLE)
/XCL: U1.8 (XCL), U2.13 (XCL)
/XSTL: U1.12 (XSTL), U2.31 (XSTL)
EPD_VDD: U1.6 (VDD), U2.5 (VDD), U2.11 (VDD), U2.34 (TEST)
GND: U1.3 (VSS), U1.7 (VSS), U1.9 (VSS), U1.26 (VSS), U1.32 (VSS), U2.9 (VSS), U2.12 (VSS), U2.22 (VSS)
