vroland/epdiy-hardware/(notices)

Notices in the files:
epdiy-v7-raw/epdiy-v7-raw.sch:
License: CC-BY-SA-4.0
parts and their libraries:
Copyright 2016 Accelerated Designs. All rights reserved.
Copyright 2021 Accelerated Designs. All rights reserved.
